HMGrunthos/InrushTimer/PCBProcessingTimes.jpg

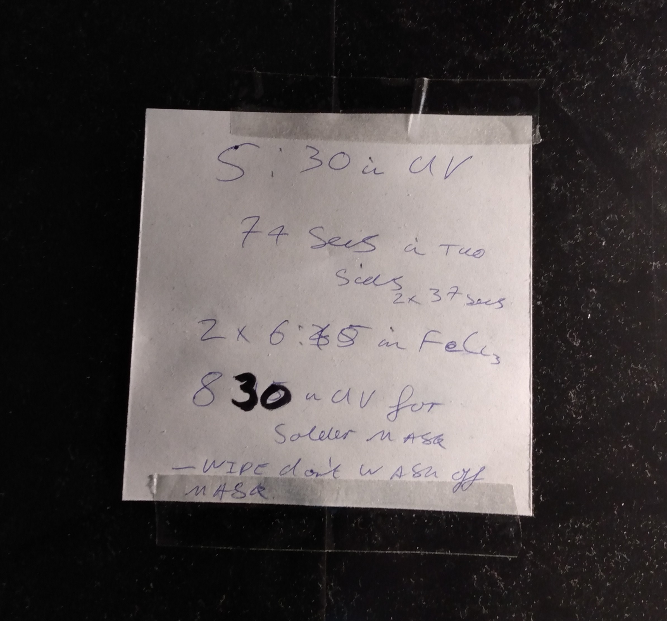
PCBProcessingTimes.jpg
