HMGrunthos/InrushTimer/InrushTimerArkwork.pdf

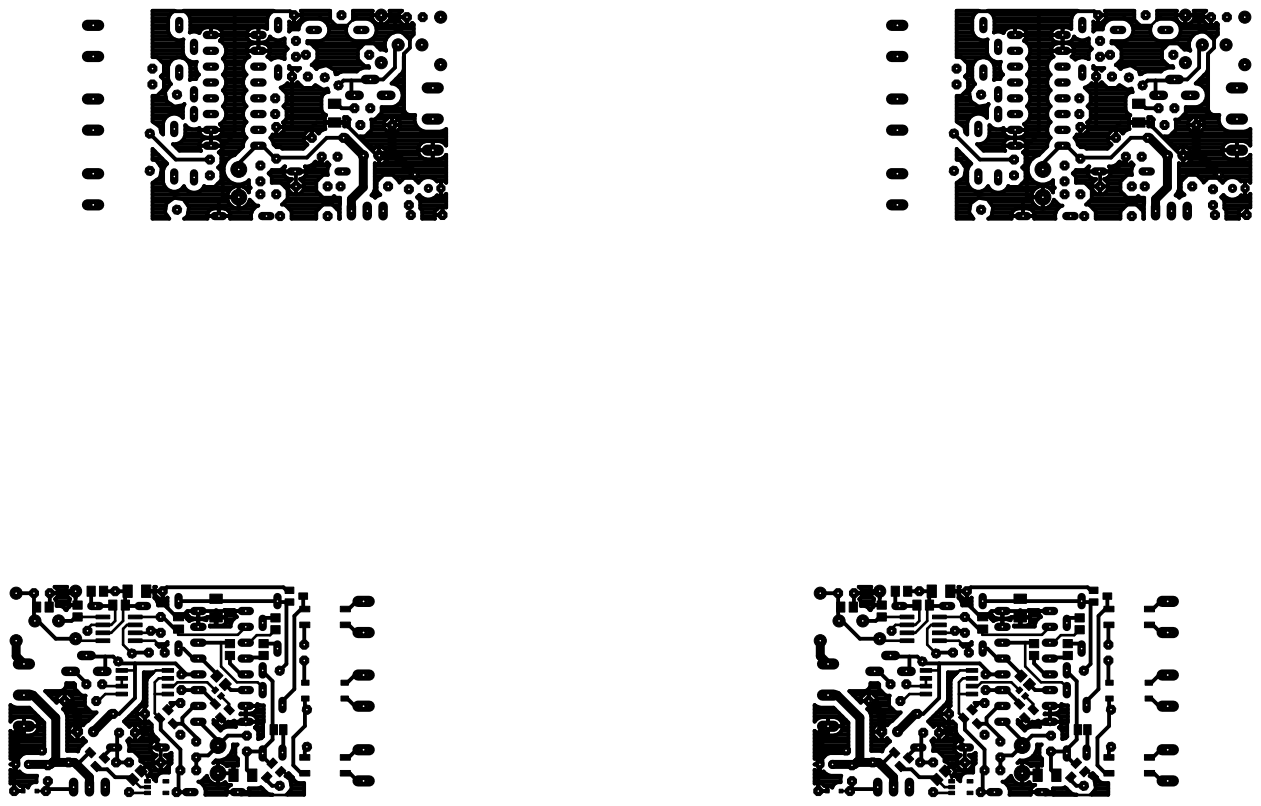
[picture p2: page 1]
