HMGrunthos/InrushTimer/InrushTimerStopMask.pdf

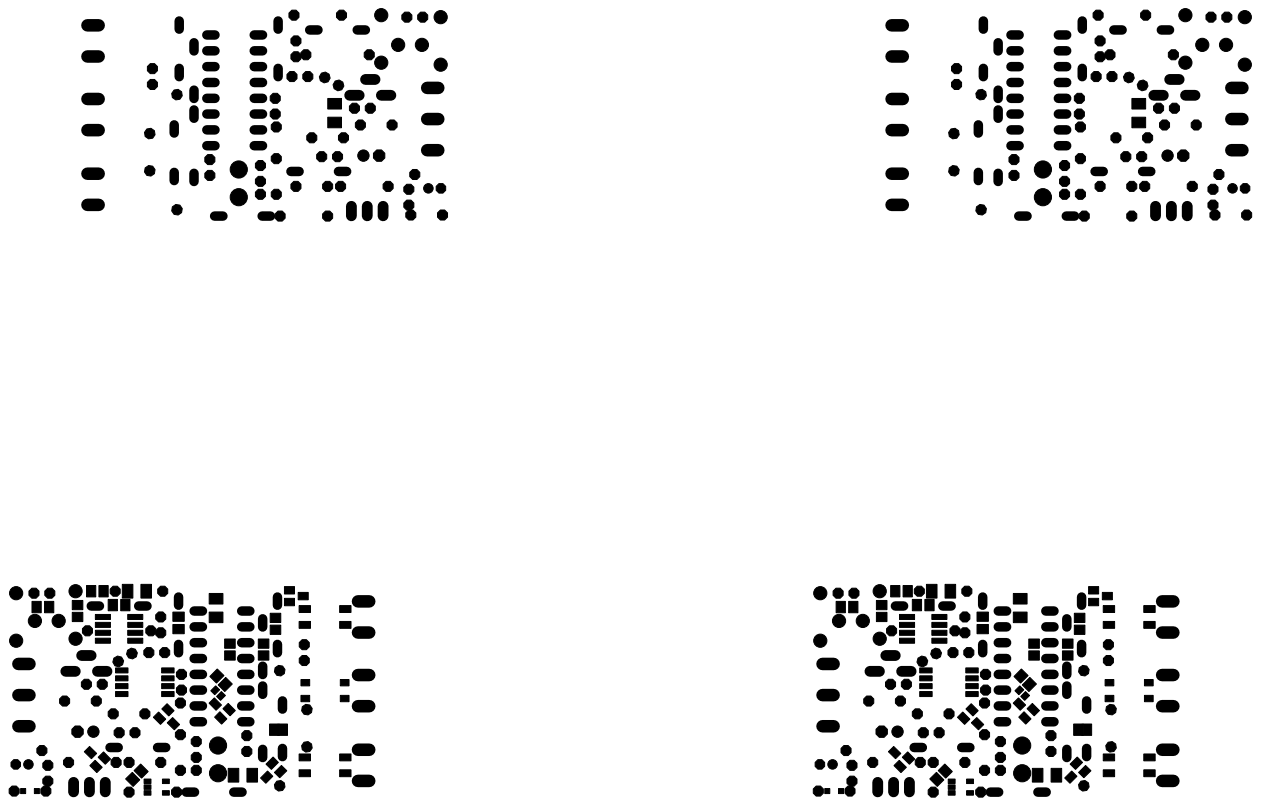
[picture p3: page 1]
