HMGrunthos/InrushTimer/InrushTimer-6.asc

A1: dflop; Trise=5n Tfall=5n Td=5n Vhigh=11.2
A2: dflop; Trise=5n Tfall=5n Td=5n Vhigh=11.2
A3: dflop; Trise=5n Tfall=5n Td=5n Vhigh=11.2
A4: dflop; Trise=5n Tfall=5n Td=5n Vhigh=11.2
C1: cap; 10e-6
C2: cap; 100e-9
C3: cap; 330e-9
C4: cap; 2e-9
C5: cap; 10e-6
C6: cap; 10e-9
C7: cap; 0.01e-6; V=16
C8: cap; 100e-6
C9: cap; 100e-9
C10: cap; 5e-12
C11: cap; 2.2e-6
C13: cap; 100e-9
C15: cap; 130e-12
C16: cap; 130e-12
C17: cap; 100e-9
C18: cap; 10e-9
C19: cap; 130e-12
D1: diode; RR2L6S
D2: diode; RR2L6S
D3: diode; RR2L6S
D4: diode; RR2L6S
D5: zener; mm3z12vt1g
D6: diode; 5082-2800
D7: diode; 1N4001
D8: diode; STTH110
D9: diode; 1N4001
D10: diode; 1N4148
D11: zener; NZX5V6C
D12: diode; 1N4148
D13: diode; 1N4148
D15: diode; 1N4148
D16: diode; 1N4148
D17: zener; NZX5V6C
L1: ind; 0.2; Rser=0.2
M2: nmos; F2N7002
M3: nmos; F2N7002
M4: nmos; F2N7002
M5: nmos; F2N7002
Q1: npn; MMBTA05
Q3: npn; ZTX450
R1: res; 100e3
R2: res; 10e3
R3: res; 22e3
R4: res; 1e6
R5: res; 4.7e3
R6: res; 51e3
R7: res; 9.1e6
R8: res; 1e3
R9: res; 22e3
R10: res; 100e3
R11: res; 100
R12: res; 200e3
R13: res; 51e3
R14: res; 1e6
R15: res; 1.5e3
R16: res; 10e3
R17: res; 200e3
R18: res; 1e3
R19: res; 10e3
R20: res; 4e3
R21: res; 4e3
R22: res; 10e3
R23: res; 200e3
R24: res; 100
R25: res; 36
R26: res; 10e3
R27: res; 4e3
R28: res; 200e3
R29: res; 27e3
R32: res; 10e3
R36: res; 10e3
U1: opamp2; TLC272
U2: opamp2; TLC272
U3: NE555
U4: bu4830
U5: LED_TRIAC_ZCS; MOC3083
U6: LED_TRIAC_ZCS; MOC3083
U7: LED_TRIAC_ZCS; MOC3083
V1: voltage; 0
V2: voltage; SINE(0 340 50 0 0 0 40); AC 1
V3: voltage; 0
W1: csw; V1 OptoSwitch
W2: csw; V3 OptoSwitch
Named nets: L, N, 12V, 0, Rect, Zero, HalfIn, Sig, Peak, PeakValue, Reset, nReset, TCharge, CV, Out, pd
.MODEL ZTX450 NPN IS =3.941445E-14 BF =175 VAF=109.45 NF =1 IKF=.8 ISE=7.4025E-15 NE =1.3 BR =20.5 VAR=14.25 NR =.974 IKR=.1 ISC=3.157E-13 NC =1.2 RB =1.1 RE =.1259 RC =.0539 CJE=63E-12 TF =.75E-9 CJC=15.8E-12 TR =85E-9 VJC=.505 MJC=.39
.lib MM3Z12VT1G.LIB
.include MOC308x.lib
.include thyristr.lib
.lib TLC272.101
.MODEL 5082-2800  D(IS=2.2E-9, CJO=1.6E-12, VJ=.6, BV=75, IBV=1E-5 EG=0.69, N=1.08, RS=25, XTI=2, M=0.5)
.lib 2N7002.lib
.tran 1
.MODEL MMBTA05  NPN (IS=51.3f NF=1.00 BF=547 VAF=139 IKF=0.146 ISE=11.1p NE=2.00 BR=4.00 NR=1.00 VAR=16.0 IKR=0.360 RE=0.223 RB=0.892 RC=89.2m XTB=1.5 CJE=58.7p VJE=1.10 MJE=0.500 CJC=18.9p VJC=0.300 MJC=0.300 TF=631p TR=110n EG=1.12 )
.ic V(TCharge)=0
.MODEL STTH110 D IS=503.98E-9 N=2.7057 RS=52.911E-3 IKF=.11996 CJO=45.822E-12 M=5.0985 VJ=9.9900 ISR=10.010E-21 NR=4.9950 FC=0.5 TT=70.000E-9
.model 1N4001 D(Is=14.11n N=1.984 Rs=33.89m Ikf=94.81 Xti=3 Eg=1.11 Cjo=25.89p M=.44 Vj=.3245 Fc=.5 Bv=75 Ibv=10u Tt=5.7u Iave=1 Vpk=50 mfg=GI type=silicon)
.MODEL TIP41C NPN (IS=7.55826e-11 BF=260.542 NF=1.11221 VAF=100 IKF=0.526814 ISE=1e-08 NE=2.18072 BR=26.0542 NR=1.5 VAR=1000 IKR=3.54059 ISC=1e-08 NC=1.63849 RB=4.56157 IRB=0.1 RBM=0.1 RE=0.0162111 RC=0.0810556 XTB=0.1 XTI=1 EG=1.206 CJE=1.93296e-10 VJE=0.4 MJE=0.259503 TF=1e-08 XTF=4.06972 VTF=7.1157 ITF=0.001 CJC=1.09657e-10 VJC=0.730921 MJC=0.23 XCJC=0.803085 FC=0.8 TR=9.01013e-08 PTF=0 Vceo=100 ICrating=6 mfg=ON_Semi)
.step param Cfc list 1e-9 3.3e-9
.model OptoSwitch CSW(Roff=1Meg Ron=1e-3 It=1mA Ih=10uA)
.inc NZX5V6C.prm
.meas TRAN PulseRise TRIG V(Peak)=1 TD=3u RISE=6 TARG V(Peak)=9 TD=3u RISE=3
At least one CLK pin capacitance
Can also be TIP41C
.meas TRAN PulseFall TRIG V(Peak)=9 TD=3u FALL=3 TARG V(Peak)=1 TD=3u FALL=6
.options cshunt=1e-15
Prefer ZTX451 for worst case CE violations
.MODEL RR2L6S D IS=1.5392E-9 N=1.6310 RS=16.849E-3 IKF=17.962 EG=.97 CJO=44.000E-12 M=.40234 VJ=.51261 ISR=1.4208E-9 NR=3.3000 BV=600 TT=5.9300E-6 TRS1=0.001
