HMGrunthos/InrushTimer/InrushProtection.asc

NTC1: xvaristor; S237_33
NTC2: xvaristor; S237_33
NTC3: xvaristor; S237_60
NTC4: xvaristor; S237_60
NTC5: xvaristor; S237_60
NTC6: xvaristor; S237_60
NTC7: xvaristor; S237_60
NTC8: xvaristor; S237_60
NTC9: xvaristor; S237_60
NTC10: xvaristor; S237_60
NTC11: xvaristor; S237_60
NTC12: xvaristor; S237_60
NTC13: xvaristor; S237_33
NTC14: xvaristor; S237_33
NTC15: xvaristor; S237_33
NTC16: xvaristor; S237_33
NTC17: xvaristor; S237_33
NTC18: xvaristor; S237_33
NTC19: xvaristor; S237_33
NTC20: xvaristor; S237_33
NTC21: xvaristor; S237_33
NTC22: xvaristor; S237_33
NTC23: xvaristor; S237_33
NTC24: xvaristor; S237_33
NTC26: xvaristor; S237_33
R1: res; 2.9
R2: res; 2.9
R3: res; 52.17
R4: res; 0
R5: res; 2.9
R6: res; 68; pwr=30
R7: res; 68; pwr=30
R8: res; 68; pwr=30
R9: res; 68; pwr=30
R10: res; 68; pwr=30
R11: res; 68; pwr=30
V1: voltage; SINE(0 340 50 0 0 0)
V2: voltage; SINE(0 340 50 0 0 0)
V3: voltage; SINE(0 340 50 0 0 0)
V4: voltage; SINE(0 340 50 0 0 0)
Named nets: 0
.tran 1
.lib ntc_20130313.lib
