HMGrunthos/InrushTimer/RelayTimer-1.asc

C1: cap; 200e-6
C2: cap; 220e-9
D1: diode; RR2L6S
D2: diode; RR2L6S
D3: diode; RR2L6S
D4: diode; RR2L6S
D5: diode; 1N4001
D6: zener; BZX84C15L
L1: ind; 200e-3; Rser=960
R1: res; 470
R2: res; 7.5e3
R5: res; 1e6
R6: res; 100
U1: SCR; EC103D1
V2: voltage; SINE(0 340 50 0 0 0 50); AC 1
Named nets: L, N, 0
.lib Thyristor_SCR_EC103xx_SxSx_A_SPICE_Model_lib.lib
.tran 2
.model 1N4001 D(Is=14.11n N=1.984 Rs=33.89m Ikf=94.81 Xti=3 Eg=1.11 Cjo=25.89p M=.44 Vj=.3245 Fc=.5 Bv=75 Ibv=10u Tt=5.7u Iave=1 Vpk=50 mfg=GI type=silicon)
