HMGrunthos/InrushTimer/InrushTimer-4.asc

A1: dflop; Trise=5n Tfall=5n Td=5n Vhigh=11.2
A2: dflop; Trise=5n Tfall=5n Td=5n Vhigh=11.2
A3: dflop; Trise=5n Tfall=5n Td=5n Vhigh=11.2
C1: cap; 10e-6
C2: cap; 100e-9
C3: cap; 220e-9
C4: cap; 1e-9
C5: cap; 10e-6
C6: cap; 10e-6
C7: cap; 0.01e-6; V=16
C8: cap; 10e-6
C9: cap; 100e-9
C10: cap; 0.01e-6; V=16
C11: cap; 1e-6
C12: cap; 10e-9
C13: cap; 100e-9
C15: cap; 10e-9
C16: cap; 130e-12
D1: diode; RR2L6S
D2: diode; RR2L6S
D3: diode; RR2L6S
D4: diode; RR2L6S
D5: zener; mm3z12vt1g
D6: diode; 5082-2800
D7: diode; 1N5819HW
D8: diode; UF5406
D9: diode; 1N5819HW
D10: diode; 1N4148
D11: zener; BZX84C15L
D12: diode; 1N4148
D13: zener; DZ2J036
L2: ind; 54.2; Rser=4e3
M1: nmos; F2N7002
M2: nmos; F2N7002
M3: nmos; F2N7002
M4: nmos; F2N7002
Q1: npn; ZTX450
R1: res; 10e3
R2: res; 200e3
R3: res; 2.2e3
R4: res; 1e6
R5: res; 4.7e3
R6: res; 51e3
R7: res; 10e6
R8: res; 51e3
R9: res; 22e3
R10: res; 200e3
R11: res; 100
R12: res; 47e3
R13: res; 51e3
R14: res; 100e3
R16: res; 37.5e3
R17: res; 37.5e3
R18: res; 1.55e3
R19: res; 25e3
R23: res; 51e3
R27: res; 47
R28: res; 330
R29: res; 2527
S1: sw; MainsOff
S2: sw; OptoOn
S3: sw; OptoOnInvert
U1: opamp2; TLC272
U2: opamp2; TLC272
U3: NE555
U4: bu4831
U5: LED_TRIAC_ZCS; MOC3083
U7: TRIAC; MAC97A6
V1: voltage; PWL(0 -1 0.324 -1 0.325 1 0.349 1 0.350 -1 0.599 -1 .600 1 .649 1 .650 -1)
V2: voltage; SINE(0 340 50); AC 1
Named nets: L, N, 12V, 0, Rect, Zero, HalfIn, Sig, Peak, Hyst, PeakValue, Reset, nReset, TCharge, CV, Out
.MODEL ZTX450 NPN IS =3.941445E-14 BF =175 VAF=109.45 NF =1 IKF=.8 ISE=7.4025E-15 NE =1.3 BR =20.5 VAR=14.25 NR =.974 IKR=.1 ISC=3.157E-13 NC =1.2 RB =1.1 RE =.1259 RC =.0539 CJE=63E-12 TF =.75E-9 CJC=15.8E-12 TR =85E-9 VJC=.505 MJC=.39
.lib MM3Z12VT1G.LIB
.include MOC308x.lib
.include thyristr.lib
.lib TLC272.101
.MODEL 5082-2800  D(IS=2.2E-9, CJO=1.6E-12, VJ=.6, BV=75, IBV=1E-5 EG=0.69, N=1.08, RS=25, XTI=2, M=0.5)
.lib 2N7002.lib
.model uf5406 d(is = 1.15563E-005 n = 3.45 rs = 0.0887337 eg = 1.11 xti = 3 cjo = 9.14327E-011 vj = 0.298558 m = 0.347605 fc = 0.5  tt = 1.57227E-007 bv = 660 ibv = 0.3 af = 1 kf = 0)
.MODEL MainsOff SW(Vt=0.0)
.lib PDTC123EM.prm
.MODEL 1N5819HW D ( IS=191u RS=42.0m BV=40.0 IBV=1.00m CJO=239p  M=0.333 N=1.70 TT=7.20n )
.tran 1.5
.MODEL MMBTA05  NPN (IS=51.3f NF=1.00 BF=547 VAF=139 IKF=0.146 ISE=11.1p NE=2.00 BR=4.00 NR=1.00 VAR=16.0 IKR=0.360 RE=0.223 RB=0.892 RC=89.2m XTB=1.5 CJE=58.7p VJE=1.10 MJE=0.500 CJC=18.9p VJC=0.300 MJC=0.300 TF=631p TR=110n EG=1.12 )
.ic V(TCharge)=0
.MODEL OptoOn SW(Vt=5)
.MODEL OptoOnInvert SW(Vt=5 Ron=1e12 Roff=1e-12)
.lib dz2j036.lib
