HMGrunthos/InrushTimer/InrushTimer-2.asc

A1: dflop
C1: cap; 10e-6
C2: cap; 100e-9
C3: cap; 220e-9
C4: cap; 1e-9
C5: cap; 10e-6
C6: cap; 10e-6
C7: cap; 0.01e-6; V=16
C8: cap; 10e-6
C9: cap; 1e-9
C10: cap; 1e-6; V=16
C11: cap; 100e-9
C12: cap; 10e-9
D1: diode; RR2L6S
D2: diode; RR2L6S
D3: diode; RR2L6S
D4: diode; RR2L6S
D5: zener; mm3z12vt1g
D6: diode; 5082-2800
D7: diode; 1N4148
D8: diode; RR2L6S
D9: diode; RR2L6S
L1: ind; 47; Rser=4e3
M1: nmos; F2N7002
Q1: npn; ZTX450
R1: res; 51e3
R2: res; 100e3
R3: res; 2.2e3
R4: res; 1e6
R5: res; 2.2e3
R6: res; 220e3
R7: res; 10e6
R8: res; 10e3
R9: res; 10e3
R10: res; 0
R11: res; 100
R12: res; 100e3
R14: res; 100e3
R16: res; 390
R17: res; 47
U1: opamp2; TLC272
U2: opamp2; TLC272
U3: NE555
U4: TRIAC; MAC97A6
V2: voltage; SINE(0 340 50)
Named nets: L, N, 12V, 0, Rect, Zero, VbrL, VbrN, Din, Sig, Ref, Adj, Peak
.MODEL ZTX450 NPN IS =3.941445E-14 BF =175 VAF=109.45 NF =1 IKF=.8 ISE=7.4025E-15 NE =1.3 BR =20.5 VAR=14.25 NR =.974 IKR=.1 ISC=3.157E-13 NC =1.2 RB =1.1 RE =.1259 RC =.0539 CJE=63E-12 TF =.75E-9 CJC=15.8E-12 TR =85E-9 VJC=.505 MJC=.39
.lib MM3Z12VT1G.LIB
.tran .5
.include MOC308x.lib
.include thyristr.lib
.lib TLC272.101
.MODEL 5082-2800  D(IS=2.2E-9, CJO=1.6E-12, VJ=.6, BV=75, IBV=1E-5 EG=0.69, N=1.08, RS=25, XTI=2, M=0.5)
.lib 2N7002.lib
