HMGrunthos/InrushTimer/InrushTimer-1.asc

C1: cap; 100e-9
C2: cap; 10e-6
C3: cap; 220e-9
C4: cap; 10e-9
C5: cap; 10e-6
C6: cap; 10e-6
C7: cap; 0.01e-6; V=16
C8: cap; 10e-6
C9: cap; 5e-6; V=16
D1: diode; RR2L6S
D2: diode; RR2L6S
D3: diode; RR2L6S
D4: diode; RR2L6S
D5: zener; mm3z12vt1g
D8: diode; 1N4148
L1: ind; 47; Rser=4e3
Q1: npn; ZTX450
R1: res; 220e3
R4: res; 1e6
R5: res; 2.2e3
R6: res; 1.8e3
R7: res; 390
R8: res; 390
R9: res; 47
R10: res; 100
U1: TRIAC; MAC97A6
U2: NE555
U3: LED_TRIAC_ZCS; moc3083
V2: voltage; SINE(0 340 50)
Named nets: L, N, 12V, 0, VTimer, Vrect, Vzero, VRef, VbrL, VbrN, Vtimer
.MODEL ZTX450 NPN IS =3.941445E-14 BF =175 VAF=109.45 NF =1 IKF=.8 ISE=7.4025E-15 NE =1.3 BR =20.5 VAR=14.25 NR =.974 IKR=.1 ISC=3.157E-13 NC =1.2 RB =1.1 RE =.1259 RC =.0539 CJE=63E-12 TF =.75E-9 CJC=15.8E-12 TR =85E-9 VJC=.505 MJC=.39
.lib MM3Z12VT1G.LIB
.tran 2
.include MOC308x.lib
.include thyristr.lib
