HMGrunthos/InrushTimer/SwitchingBoardKiCad/SwitchingBoard.kicad_pcb

## KiCad design SwitchingBoardKiCad/SwitchingBoard.kicad_pcb (2022-06-03)

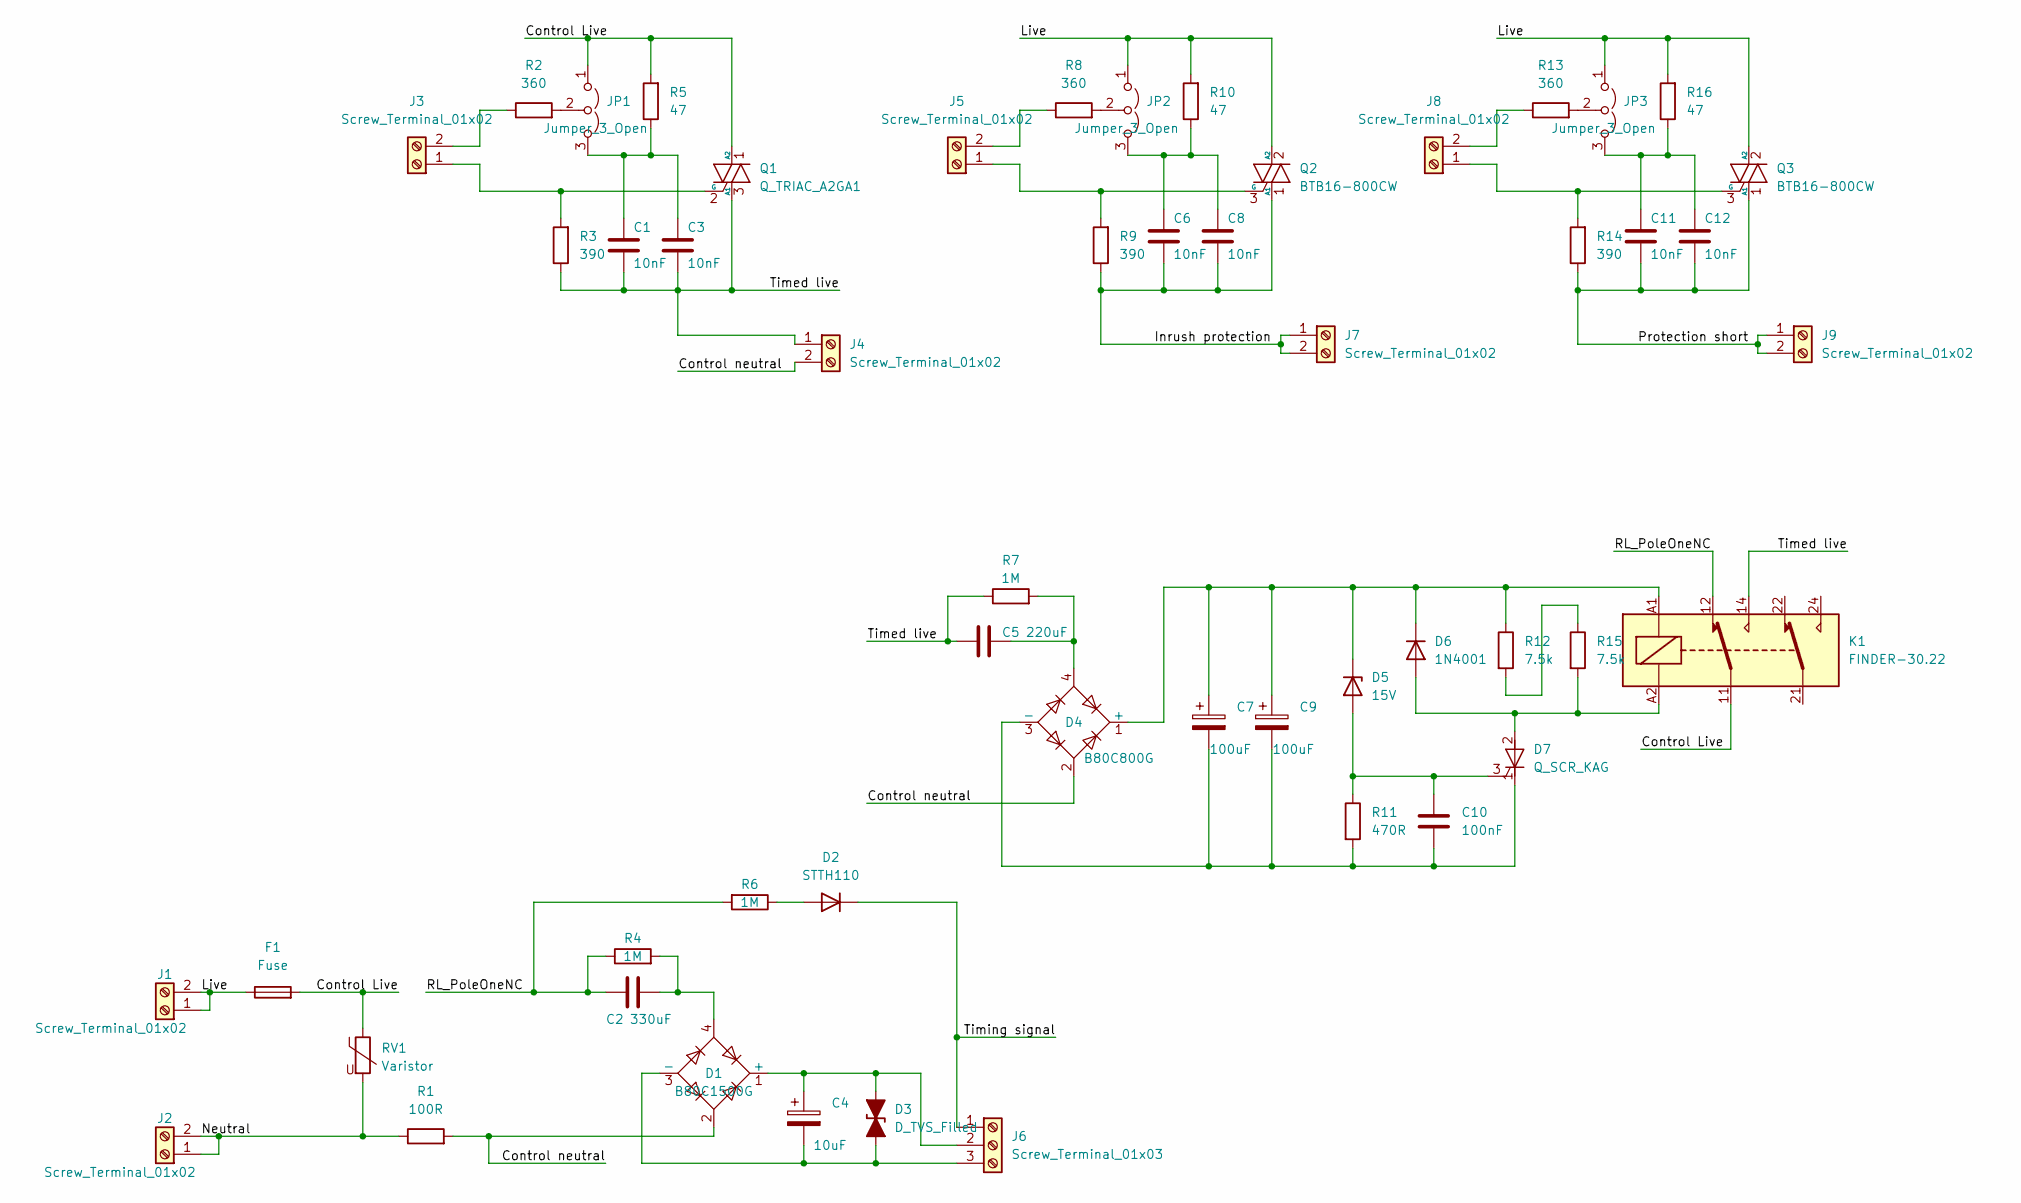
[picture p4: schematic SwitchingBoard.kicad_sch]

Parts:
C1, C3, C6, C8, C11, C12: 10nF; C_Rect_L18.0mm_W5.0mm_P15.00mm_FKS3_FKP3
C2: 330uF; C_Rect_L18.0mm_W9.0mm_P15.00mm_FKS3_FKP3
C4: 10uF; CP_Radial_D5.0mm_P2.00mm
C5: 220uF; C_Rect_L26.5mm_W6.0mm_P22.50mm_MKS4
C7, C9: 100uF; CP_Radial_D6.3mm_P2.50mm
C10: 100nF; C_Disc_D5.0mm_W2.5mm_P5.00mm
D1: B80C1500G; Diode_Bridge_Round_D9.8mm
D2: STTH110; D_DO-41_SOD81_P10.16mm_Horizontal
D3: D_TVS_Filled; D_DO-15_P12.70mm_Horizontal
D4: B80C800G; Diode_Bridge_Round_D9.8mm
D5: 15V; D_DO-35_SOD27_P7.62mm_Horizontal
D6: 1N4001; D_DO-41_SOD81_P10.16mm_Horizontal
D7: Q_SCR_KAG; TO-220-3_Horizontal_TabDown
F1: Fuse; Fuseholder_Clip-5x20mmOr6.3x32_Schurter_OG_Lateral_P20.00x5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
J1, J2, J3, J4, J5, J7, J8, J9: Screw_Terminal_01x02; TerminalBlock_Altech_AK300-2_P5.00mm
J6: Screw_Terminal_01x03; TerminalBlock_Altech_AK300-3_P5.00mm
JP1, JP2, JP3: Jumper_3_Open; TerminalBlock_4Ucon_1x03_P3.50mm_Horizontal
K1: FINDER-30.22; Relay_DPDT_Finder_40.52
Q1: Q_TRIAC_A2GA1; TO-92L_Inline
Q2, Q3: BTB16-800CW; TO-220-3_Vertical
R1: 100R; R_Axial_Power_L20.0mm_W6.4mm_P22.40mm
R2, R8, R13: 360; R_Axial_DIN0207_L6.3mm_D2.5mm_P10.16mm_Horizontal
R3, R9, R14: 390; R_Axial_DIN0207_L6.3mm_D2.5mm_P10.16mm_Horizontal
R4, R6, R7: 1M; R_Axial_Power_L20.0mm_W6.4mm_P22.40mm
R5, R10, R16: 47; R_Axial_DIN0207_L6.3mm_D2.5mm_P10.16mm_Horizontal
R11: 470R; R_Axial_DIN0207_L6.3mm_D2.5mm_P10.16mm_Horizontal
R12, R15: 7.5k; R_Axial_DIN0207_L6.3mm_D2.5mm_P10.16mm_Horizontal
RV1: Varistor; RV_Disc_D12mm_W4.3mm_P7.5mm

Connections:
/Control Live: F1.2, JP1.1 (A), K1.11, Q1.1 (A2), R5.2, RV1.1
/Control neutral: D1.2, D4.2, J4.2, R1.2
/Inrush protection: C6.1, C8.1, J7.1, J7.2, Q2.1 (A1), R9.1
/Live: F1.1, J1.1, J1.2, JP2.1 (A), JP3.1 (A), Q2.2 (A2), Q3.2 (A2), R10.2, R16.2
/Neutral: J2.1, J2.2, R1.1, RV1.2
/Protection short: C11.1, C12.1, J9.1, J9.2, Q3.1 (A1), R14.1
/RL_PoleOneNC: C2.1, K1.12, R4.1, R6.2
/Timed live: C1.1, C3.1, C5.1, J4.1, K1.14, Q1.3 (A1), R3.1, R7.1
/Timing signal: D2.1 (K), J6.1
unnamed: C1.2, C3.2, JP1.3 (B), R5.1
unnamed: C2.2, D1.4, R4.2
unnamed: C4.1, D1.1 (+), D3.2 (A2), J6.2
unnamed: C4.2, D1.3 (-), D3.1 (A1), J6.3
unnamed: C5.2, D4.4, R7.2
unnamed: C6.2, C8.2, JP2.3 (B), R10.1
unnamed: C7.1, C9.1, D4.1 (+), D5.1 (K), D6.1 (K), K1.A1, R12.1
unnamed: C7.2, C9.2, C10.1, D4.3 (-), D7.1 (K), R11.2
unnamed: C10.2, D5.2 (A), D7.3 (G), R11.1
unnamed: C11.2, C12.2, JP3.3 (B), R16.1
unnamed: D2.2 (A), R6.1
unnamed: D6.2 (A), D7.2 (A), K1.A2, R15.2
unnamed: J3.1, Q1.2 (G), R3.2
unnamed: J3.2, R2.1
unnamed: J5.1, Q2.3 (G), R9.2
unnamed: J5.2, R8.1
unnamed: J8.1, Q3.3 (G), R14.2
unnamed: J8.2, R13.1
unnamed: JP1.2 (C), R2.2
unnamed: JP2.2 (C), R8.2
unnamed: JP3.2 (C), R13.2
unnamed: R12.2, R15.1

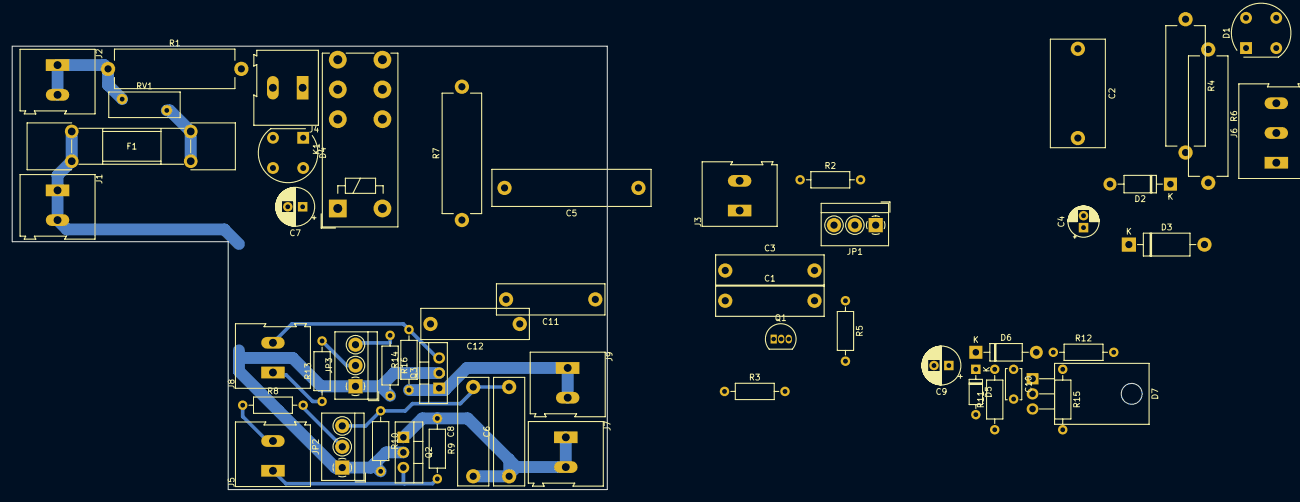
[picture p5: board SwitchingBoard.kicad_pcb from above]

Board: 2 copper layers, 100.0 x 74.5 mm, 53 parts (0 on the bottom side), 31 nets.
