HMGrunthos/InrushTimer/InrushTimer.brd

## EAGLE design InrushTimer.brd (2022-10-17)

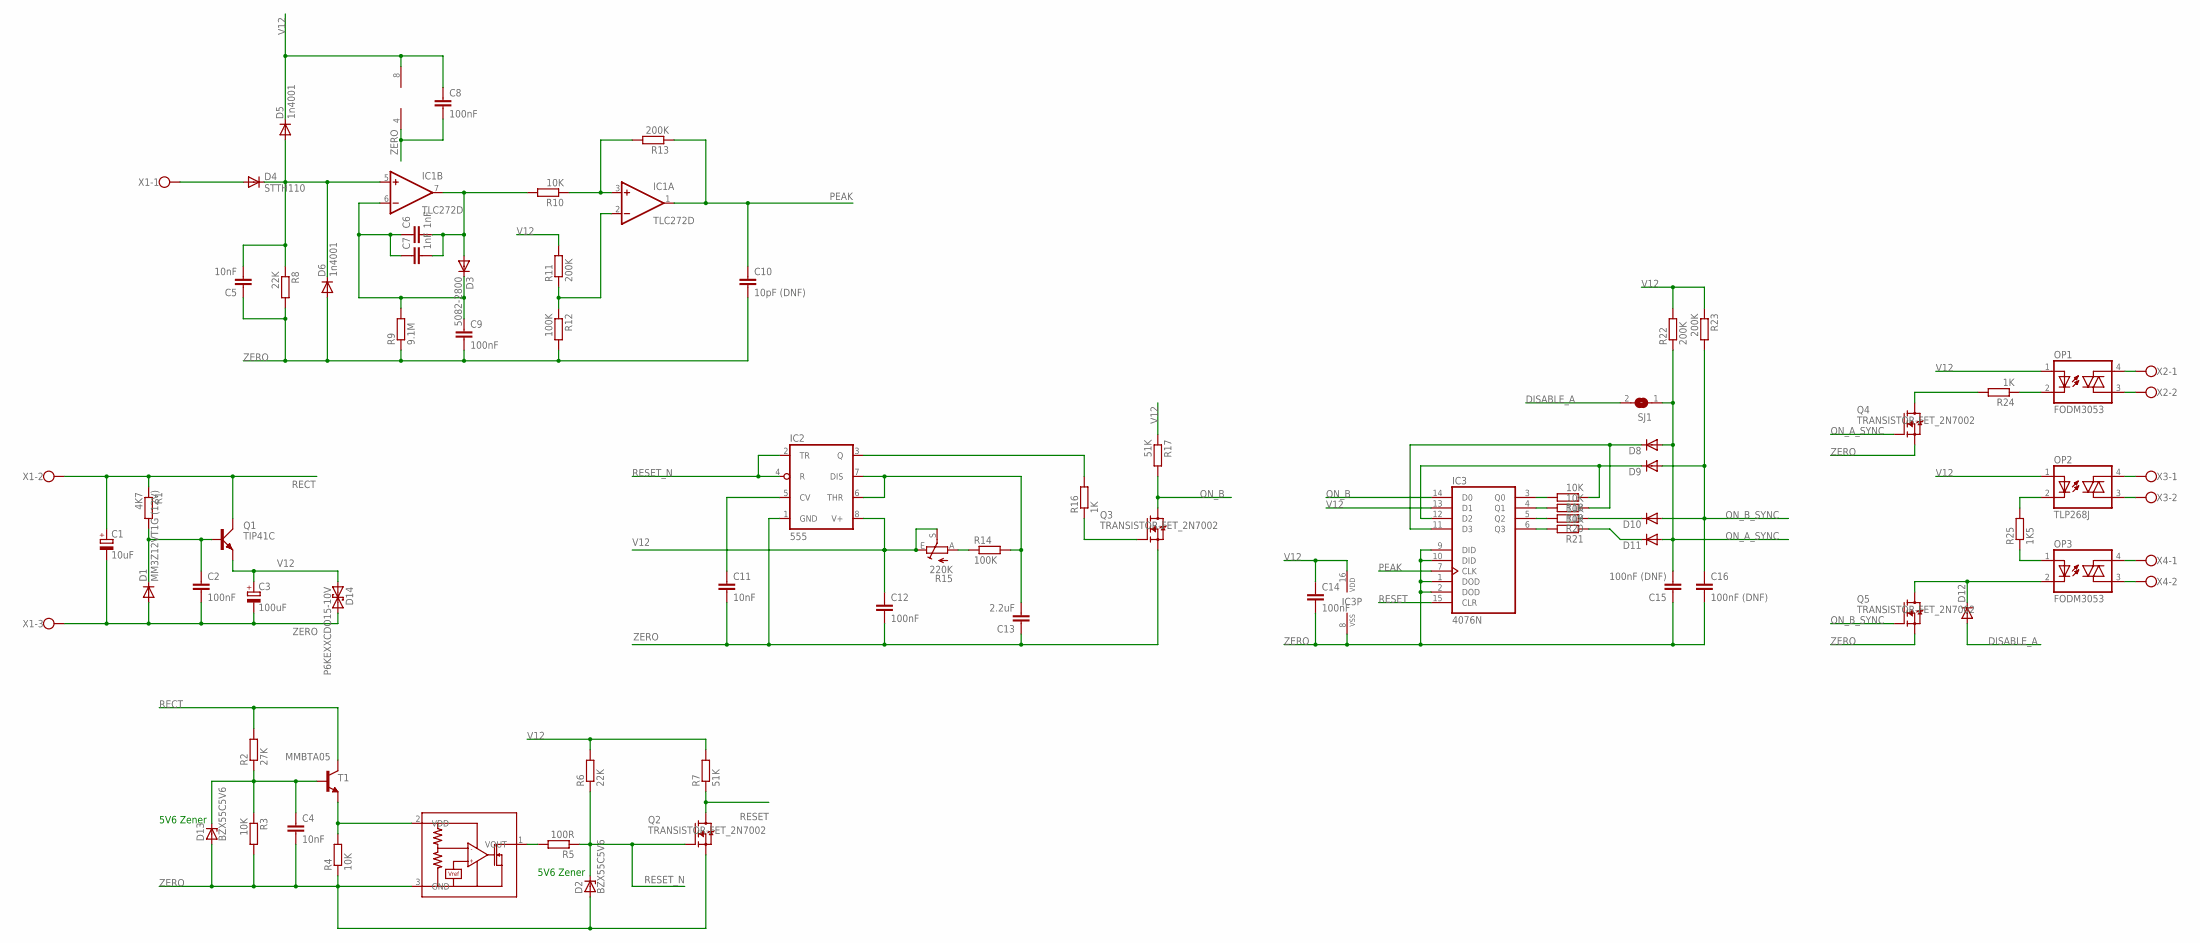
[picture p6: schematic InrushTimer.sch]

Parts:
C1: 10uF; E2-5
C2, C12, C14: 100nF; C050-024X044
C3: 100uF; E2,5-7
C4, C11: 10nF; C050-024X044
C5: 10nF; C0805K
C6, C7: 1nF; C0805K
C8: 100nF; C0805
C9: 100nF; C1206K
C10: 10pF (DNF); C0805K
C13: 2.2uF; C1206K
C15, C16: 100nF (DNF); C1206K
D1: MM3Z12VT1G (12V); SOD323-R
D2, D13: BZX55C5V6; DO34Z7
D3: 5082-2800; DO34-7
D4: STTH110; DO41-7.6
D5: 1n4001; DO41-10VN
D6: 1n4001; DO41-7.6
D8: 1N4148DO35-10; DO35-10
D9, D10, D11, D12: 1N4148DO35-7; DO35-7
D14: P6KEXXCDO15-10V; DO15-10V
IC1: TLC272D; SO08
IC2: 555; SO08-555
IC3: 4076N; DIL16
OP1, OP3: FODM3053; FODM
OP2: TLP268J; TLP26*
Q1: TIP41C; TO220AV
Q2, Q3, Q4, Q5: TRANSISTOR-FET_2N7002; TRANSISTOR-FET_SOT23
R1: 4K7; 0207/2V
R2: 27K; 0207/7
R3: 10K; 0207/2V
R4, R18, R19, R20, R21: 10K; R0805
R5: 100R; 0207/7
R6, R8: 22K; 0207/2V
R7, R17: 51K; 0207/2V
R9: 9.1M; 0207/7
R10: 10K; 0207/10
R11, R13, R22: 200K; 0207/2V
R12, R14: 100K; 0207/2V
R15: 220K; CA6H
R16: 1K; R0402
R23: 200K; 0207/7
R24: 1K; 0207/7
R25: 1K5; 0207/2V
SJ1: SJ
T1: MMBTA05; SOT23-BEC
U1: ROHM_BY_ELEMENT14_BATCH_1_BU48XXG; ROHM_BY_ELEMENT14_BATCH_1_SOT95P280X125-5N
X1: W237-103
X2, X3, X4: W237-102

Connections:
DISABLE_A: D12.A, SJ1.2
unnamed: D4.A, X1.1
unnamed: R14.1, R15.A
unnamed: IC3.6 (Q3), R21.2
unnamed: OP3.4 (A2), X4.1
unnamed: OP1.3 (A1), X2.2
unnamed: D12.C, OP3.2 (C), Q5.3 (D)
unnamed: C6.2, C7.2, D3.A, IC1.7 (OUT), R10.2
unnamed: C2.1, D1.C, Q1.B, R1.2
unnamed: C6.1, C7.1, C9.1, D3.C, IC1.6 (-IN), R9.2
unnamed: OP1.4 (A2), X2.1
unnamed: C5.2, D4.C, D5.A, D6.C, IC1.5 (+IN), R8.1
unnamed: OP3.3 (A1), X4.2
unnamed: R4.2, T1.E, U1.2 (VDD)
unnamed: C4.1, D13.C, R2.1, R3.1, T1.B
unnamed: OP3.1 (A), R25.1
unnamed: D9.C, IC3.12 (D2), R18.1
unnamed: OP2.2 (C), R25.2
unnamed: OP1.2 (C), R24.1
unnamed: IC3.5 (Q2), R20.2
unnamed: OP2.4 (A2), X3.1
unnamed: OP2.3 (A1), X3.2
unnamed: D8.C, IC3.11 (D3), R19.1
unnamed: R5.2, U1.1 (VOUT)
unnamed: D11.C, R21.1
unnamed: IC3.4 (Q1), R19.2
unnamed: IC1.3 (+IN), R10.1, R13.2
unnamed: C13.2, IC2.6 (THR), IC2.7 (DIS), R14.2
unnamed: D10.C, R20.1
unnamed: Q4.3 (D), R24.2
unnamed: IC3.3 (Q0), R18.2
unnamed: Q3.1 (G), R16.1
unnamed: C11.1, IC2.5 (CV)
unnamed: IC2.3 (Q), R16.2
ON_A_SYNC: C15.2, D8.A, D11.A, Q4.1 (G), R22.1, SJ1.1
ON_B: IC3.14 (D0), Q3.3 (D), R17.2
ON_B_SYNC: C16.1, D9.A, D10.A, Q5.1 (G), R23.2
PEAK: C10.1, IC1.1 (OUT), IC3.7 (CLK), R13.1
RECT: C1.+, Q1.C, R1.1, R2.2, T1.C, X1.2
RESET: IC3.15 (CLR), Q2.3 (D), R7.1
RESET_N: D2.C, IC2.2 (TR), IC2.4 (R), Q2.1 (G), R5.1, R6.1
THRESH: IC1.2 (-IN), R11.1, R12.1
V12: C3.+, C8.1, C12.1, C14.1, D5.C, D14.A (1), IC1.8 (V+), IC2.8 (V+), IC3.13 (D1), IC3.16 (VDD), OP1.1 (A), OP2.1 (A), Q1.E, R6.2, R7.2, R11.2, R15.E, R15.S, R17.1, R22.2, R23.1
ZERO: C1.-, C2.2, C3.-, C4.2, C5.1, C8.2, C9.2, C10.2, C11.2, C12.2, C13.1, C14.2, C15.1, C16.2, D1.A, D2.A, D6.A, D13.A, D14.C (2), IC1.4 (V-), IC2.1 (GND), IC3.1 (DOD), IC3.2 (DOD), IC3.8 (VSS), IC3.9 (DID), IC3.10 (DID), Q2.2 (S), Q3.2 (S), Q4.2 (S), Q5.2 (S), R3.2, R4.1, R8.2, R9.1, R12.2, U1.3 (GND), X1.3

Notes on the sheet:
5V6 Zener

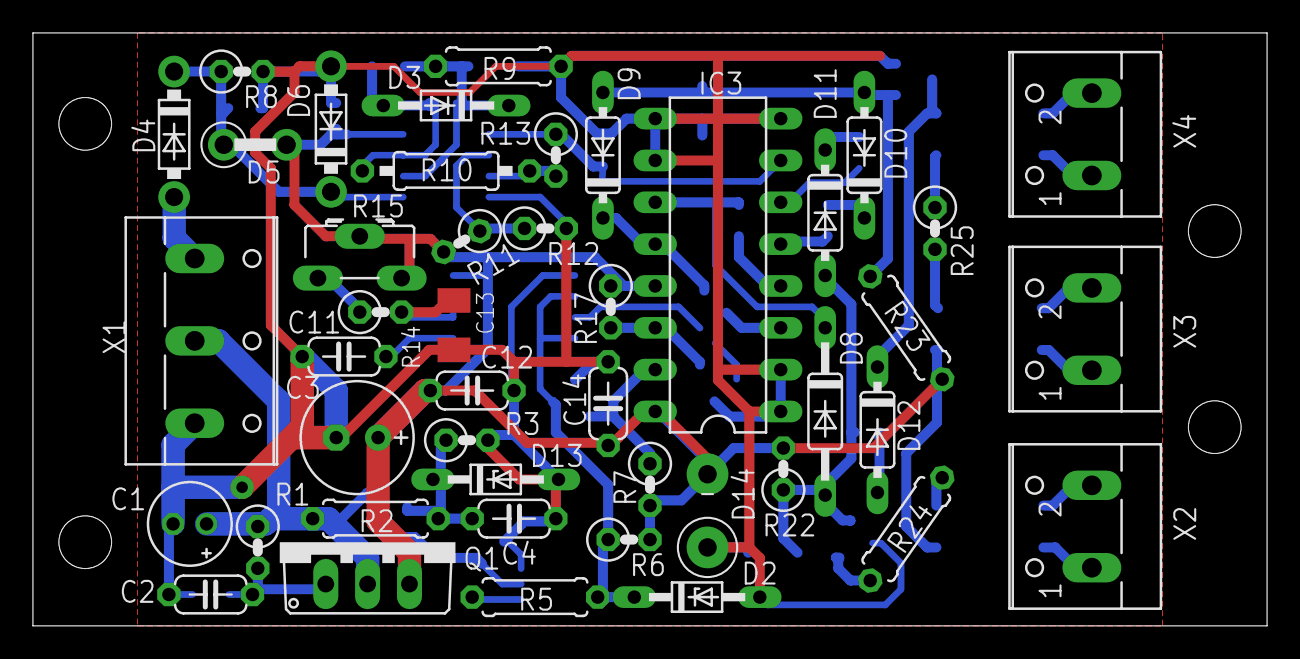
[picture p7: board InrushTimer.brd from above]

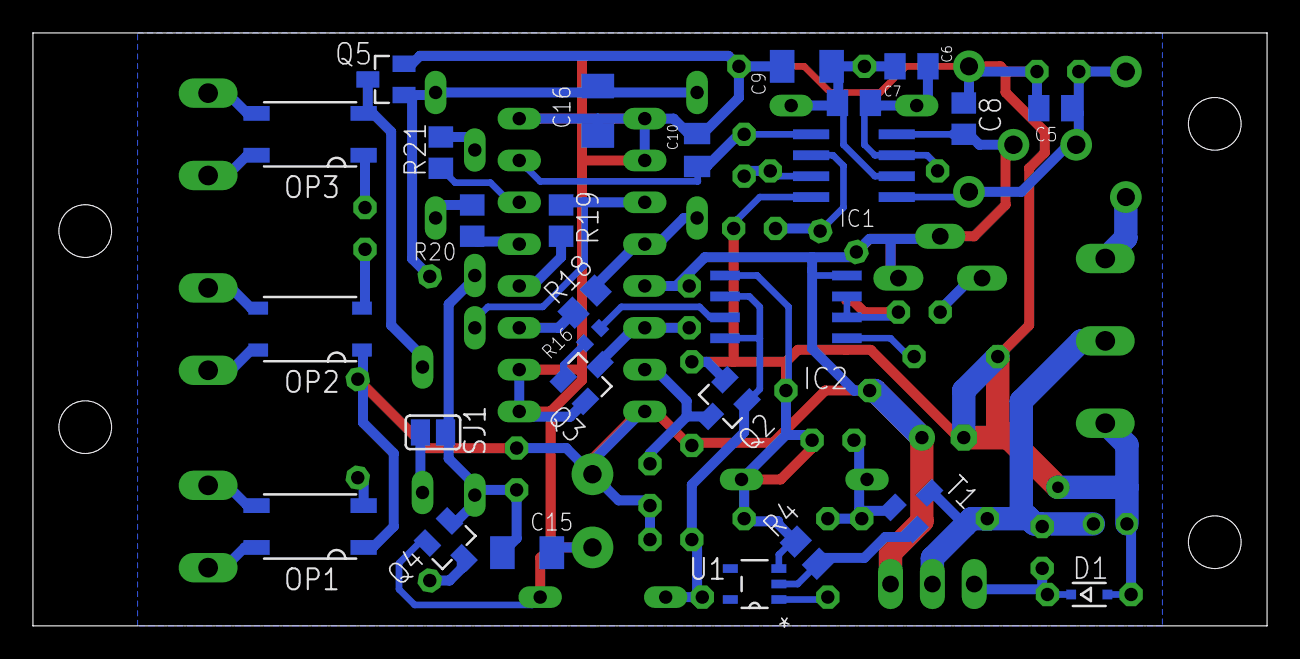
[picture p8: board InrushTimer.brd from below]

Board: 2 copper layers, 74.9 x 36.0 mm, 72 parts (27 on the bottom side), 44 nets.
