HMGrunthos/InrushTimer/SwitchingBoard.brd

## EAGLE design SwitchingBoard.brd (2022-05-04)

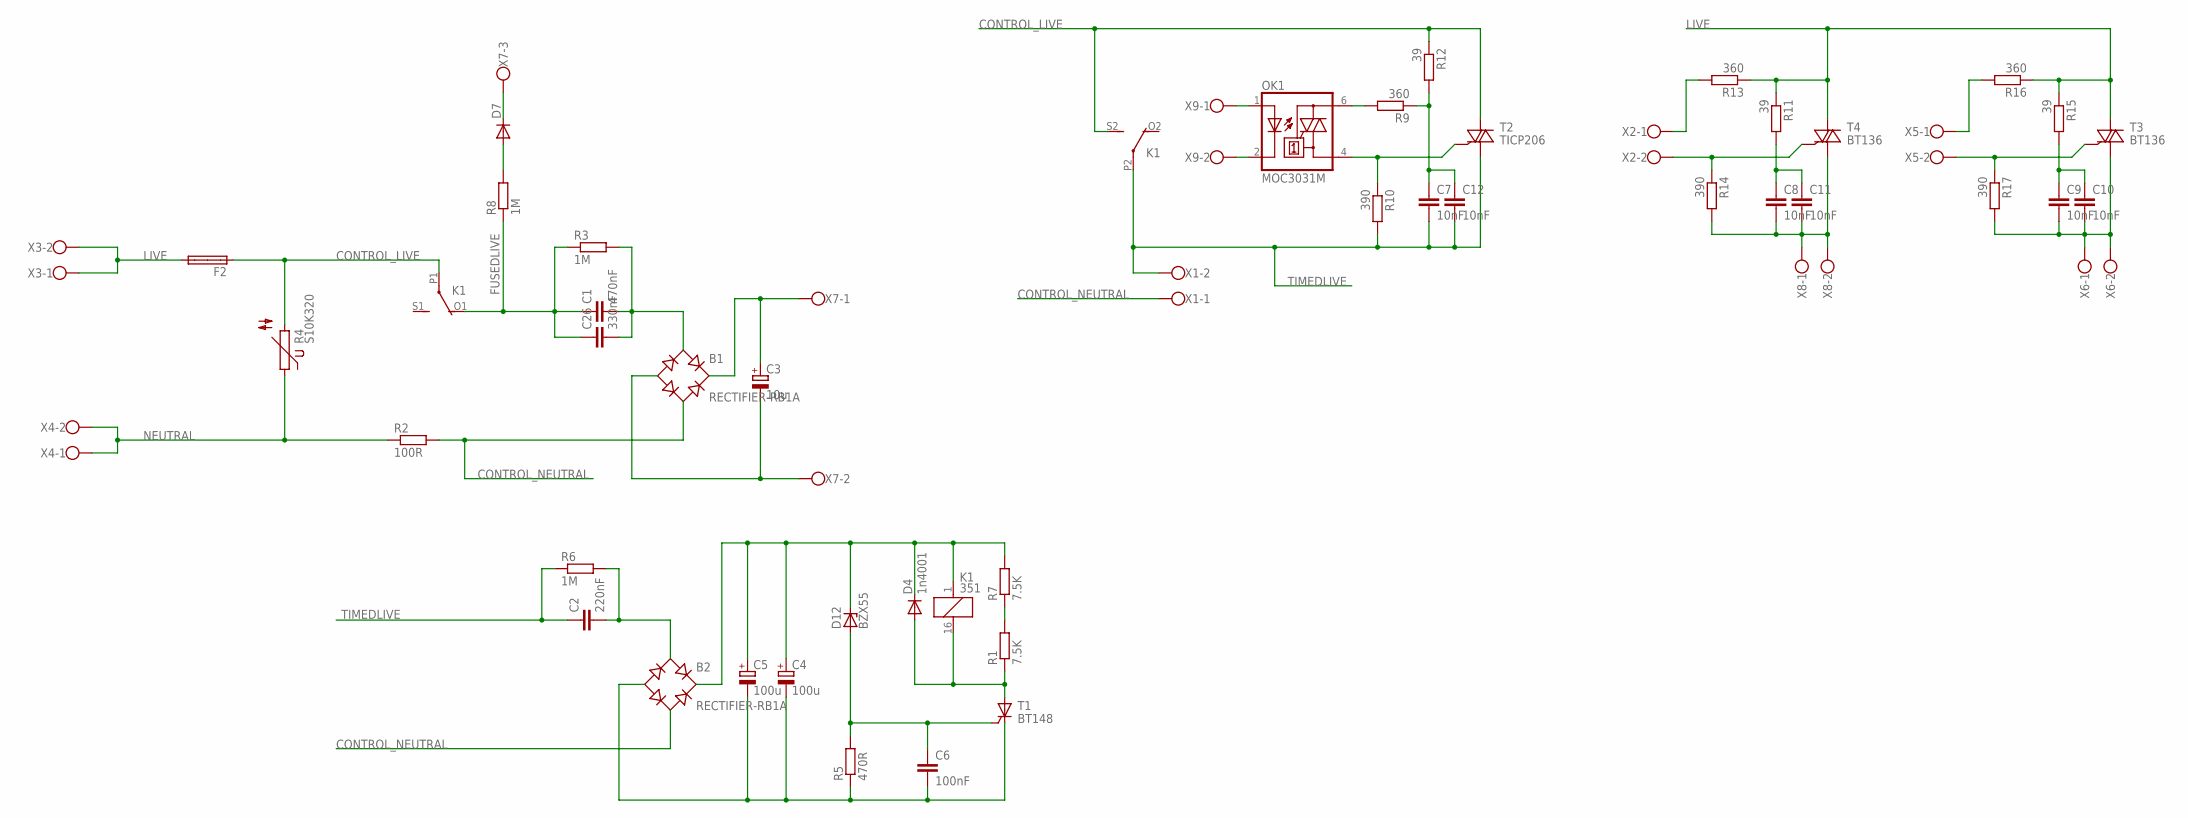
[picture p9: schematic SwitchingBoard.sch]

Parts:
B1, B2: RECTIFIER-RB1A; RB1A
C1: 470nF; C225-108X268
C2: 220nF; C225-062X268
C3: 10u; E2-5
C4, C5: 100u; E2,5-7
C6: 100nF; C050-024X044
C7, C8, C9: 10nF; C150-054X183
C10, C11, C12: 10nF; C102-043X133
C26: 330nF; C150-091X182
D4: 1n4001; DO41-10
D7: DIODE-DO41-10; DO41-10
D12: BZX55; DO35Z10
F2: SHKOG
K1: 351
OK1: MOC3031M; DIL06
R1, R7: 7.5K; 0207/7
R2: 100R; 0617/22
R3, R6, R8: 1M; 0617/22
R4: S10K320
R5: 470R; 0207/7
R9, R13, R16: 360; 0207/7
R10, R14, R17: 390; 0207/7
R11, R12, R15: 39; 0207/7
T1: BT148; SOT82S
T2: TICP206; TO92-6
T3, T4: BT136; TO220AB
X1, X2, X3, X4, X5, X6, X8, X9: W237-102
X7: W237-103

Connections:
CONTROL_LIVE: F2.1A, K1.P1, K1.S2 (S), R4.2, R12.1, T2.A2
CONTROL_NEUTRAL: B1.AC2, B2.AC2, R2.2, X1.1
FUSEDLIVE: C1.1, C26.1, K1.O1 (O), R3.1, R8.1
LIVE: F2.2A, R11.1, R13.1, R15.1, R16.1, T3.2 (A2), T4.2 (A2), X3.1, X3.2
unnamed: D7.A, R8.2
unnamed: B2.AC1, C2.2, R6.2
unnamed: R1.2, R7.1
unnamed: B1.AC1, C1.2, C26.2, R3.2
unnamed: D7.C, X7.3
unnamed: D4.A, K1.16 (2), R1.1, T1.A
unnamed: C6.1, D12.A, R5.2, T1.G
unnamed: C8.2, C11.2, R14.2, T4.1 (A1), X8.1, X8.2
unnamed: OK1.6 (A2), R9.2
unnamed: OK1.1 (A), X9.1
unnamed: C9.2, C10.2, R17.2, T3.1 (A1), X6.1, X6.2
unnamed: OK1.2 (C), X9.2
unnamed: OK1.4 (A1), R10.1, T2.G
unnamed: C7.1, C12.1, R9.1, R12.2
unnamed: R13.2, X2.1
unnamed: C8.1, C11.1, R11.2
unnamed: R14.1, T4.3 (G), X2.2
unnamed: C9.1, C10.1, R15.2
unnamed: R16.2, X5.1
unnamed: R17.1, T3.3 (G), X5.2
NEUTRAL: R2.1, R4.1, X4.1, X4.2
RECT: B1.+, C3.+, X7.1
RECTRELAY: B2.+, C4.+, C5.+, D4.C, D12.C, K1.1, R7.2
TIMEDLIVE: C2.1, C7.2, C12.2, K1.P2, R6.1, R10.2, T2.A1, X1.2
ZERO: B1.-, C3.-, X7.2
ZERO1: B2.-, C4.-, C5.-, C6.2, R5.1, T1.C

Board: 2 copper layers, 51 parts (0 on the bottom side), 30 nets, no tracks yet.
