HMGrunthos/InrushTimer/(commit log)

2018-07-06 Adding all inrush timer design files and libraries
2018-07-11 Added peak detector opamps
    [InrushTimer.brd, InrushTimer.sch]
2018-07-13 Still playing with 555 design, peak detector clock seems OK
    [InrushTimer.brd, InrushTimer.sch]
2018-08-28 Updating prior to PCB layout
    [InrushTimer.brd, InrushTimer.sch]
2018-08-28 Added 3.6V zenner
2022-04-25 Tweaked design and updated component footprints
    [InrushTimer.brd, InrushTimer.sch]
2022-04-28 Adding relay delay module and updates to inrush timer.
    [InrushTimer.brd, InrushTimer.sch]
2022-04-28 Updating with inrush model and chenges to cap values to support additional triac channel
    [InrushTimer.brd, InrushTimer.sch]
2022-04-30 Committing first cut of the board design. Two control signals unrouted.
    [InrushTimer.brd, InrushTimer.sch]
2022-05-01 Updated some component values and squished the timers further to the right.
    [InrushTimer.brd, InrushTimer.sch]
2022-05-01 Initial version of routed PCB. All traces routed and passes cursory DRC.
    [InrushTimer.brd, InrushTimer.sch]
2022-05-01 Tweaked layout to meet more exacting design rules.
    [InrushTimer.brd]
2022-05-01 Fixed missing track. Tweaked track widths.
    [InrushTimer.brd]
2022-05-01 Fixed an incorred footprint.
    [InrushTimer.brd, InrushTimer.sch]
2022-05-02 Tidied up some traces and improved trace seraration.
    [InrushTimer.brd, InrushTimer.sch]
2022-05-03 Trace adjustments.
    [InrushTimer.brd]
2022-05-04 Adding switching board design.
    [SwitchingBoard.brd, SwitchingBoard.sch]
2022-05-04 Updated schematics and parts for the switching board.
    [SwitchingBoard.brd, SwitchingBoard.sch]
2022-05-05 Checking in first version of the switching board layed out in KiCad
    [SwitchingBoard.kicad_pcb, SwitchingBoard.kicad_sch]
2022-05-05 KiCad switching board schematic passes initial ERC.
    [SwitchingBoard.kicad_sch]
2022-05-05 Assigned footprints
    [SwitchingBoard.kicad_sch]
2022-05-05 Initial grouping of components on PCB
    [SwitchingBoard.kicad_pcb, SwitchingBoard.kicad_sch]
2022-05-07 Tweaked layout based on autorouter run.
    [InrushTimer.brd, InrushTimer.sch]
2022-05-07 Updated schematics and board to address error in aux output assignment.
    [InrushTimer.brd, InrushTimer.sch]
2022-05-12 Committing changes to circuit to remove a time and put the optoisolators into series.
    [InrushTimer.brd, InrushTimer.sch]
2022-05-12 Simplified resistive divider setup.
2022-05-13 Updated model and board with circuit and component values.
    [InrushTimer.brd, InrushTimer.sch]
2022-05-13 Changed gate resistors and checked component values.
    [InrushTimer.brd, InrushTimer.sch]
2022-05-13 Added inductor model and tweaked schematic.
    [InrushTimer.brd, InrushTimer.sch]
2022-05-14 Fixed inverted comparator and actually calculated hysteresis resistors!
2022-05-14 Updated values and topology on schematic.
    [InrushTimer.brd, InrushTimer.sch]
2022-05-14 Corrected component values (units)
    [InrushTimer.brd, InrushTimer.sch]
2022-05-14 Tidied up model schematic.
2022-05-14 Updated optotriac symbol
    [InrushTimer.brd, InrushTimer.sch]
2022-05-14 Fixed missing libraries by moving parts into local lib. Renumbered components.
    [InrushTimer.brd, InrushTimer.sch]
2022-05-14 Updated component packages
    [InrushTimer.brd, InrushTimer.sch]
2022-05-14 Updated zener model and added annotation on schematic.
    [InrushTimer.brd, InrushTimer.sch]
2022-05-15 Added measurements for peak clock rise and fall time. Tidied up library imports. Sorted out gate capacitance on output of comparator.
2022-05-15 Removed ||'ll resistance for looking at peak voltage. Removed unused models.
2022-05-15 Re-layed out peak detector, supply and reset generator.
    [InrushTimer.brd, InrushTimer.sch]
2022-05-15 Layout changes.
    [InrushTimer.brd]
2022-05-16 Removed optocoupler from this board and updated the fuseholder footprint.
    [SwitchingBoard.kicad_pcb, SwitchingBoard.kicad_sch]
2022-05-17 ayed out the timer - starting on the D types. Fixed incorrect gate capacitance.
    [InrushTimer.brd, InrushTimer.sch]
2022-05-17 Added custom fuse footprint and updated PCB.
    [SwitchingBoard.kicad_pcb, SwitchingBoard.kicad_sch]
2022-05-17 Refitted the timer and pulse generator.
    [InrushTimer.brd, InrushTimer.sch]
2022-05-17 Everything on the board - not routed.
    [InrushTimer.brd]
2022-05-17 Added a couple more power routes.
    [InrushTimer.brd]
2022-05-18 First complete routing fit. Passes design rules.
    [InrushTimer.brd, InrushTimer.sch]
2022-05-18 Slight track style tweaks.
    [InrushTimer.brd, InrushTimer.sch]
2022-05-20 Pushed some tracks to the bottom side
    [InrushTimer.brd, InrushTimer.sch]
2022-05-20 Adjusted resistor value
2022-05-20 Shifted component to the bottom layer and adjusted some track placements.
    [InrushTimer.brd, InrushTimer.sch]
2022-05-20 Track and component positions.
    [InrushTimer.brd]
2022-05-20 Tidied up component and track placement.
    [InrushTimer.brd, InrushTimer.sch]
2022-05-20 Rev two layout - minor change to track angle
    [InrushTimer.brd]
2022-05-23 Added photo of PCB processing notes.
2022-05-25 Changed pass element to TIP41C and moved some components around to make more space.
    [InrushTimer.brd, InrushTimer.sch]
2022-05-25 Rerouted power supply section and made some space around the pot.
    [InrushTimer.brd, InrushTimer.sch]
2022-05-25 Fixed some component orientations.
    [InrushTimer.brd, InrushTimer.sch]
2022-05-26 Tweaked ground and component positions - still to do; adjust pad sizes.
    [InrushTimer.brd]
2022-05-27 Increased TH pad sizes and adjusted component positions to pass DRC.
    [InrushTimer.brd, InrushTimer.sch]
2022-05-29 Tweaked track position.
    [InrushTimer.brd]
2022-06-01 Playing with layout and routing in KiCad
    [SwitchingBoard.kicad_pcb, SwitchingBoard.kicad_sch]
2022-06-03 Shuffled component placement to avoid via.
    [SwitchingBoard.kicad_pcb]
2022-06-03 Fixed TRIAC symbol and tweaked layout further.
    [SwitchingBoard.kicad_pcb, SwitchingBoard.kicad_sch]
2022-08-25 Added duplicated resistors to hit worst case voltage ratings.
    [SwitchingBoard.kicad_sch]
2022-10-17 Fixed up silkscreen and added job file from JLCPCB
    [InrushTimer.brd, InrushTimer.sch]
2022-10-17 More silkscreen fixes.
    [InrushTimer.brd]
2022-10-18 Checked in gerber files for inrush timer production.
    [InrushTimer.GBL, InrushTimer.GBO, InrushTimer.GBP, InrushTimer.GBS, InrushTimer.GKO, InrushTimer.GTL, InrushTimer.GTO, InrushTimer.GTP]
2022-12-14 Fixed schematic connections.
    [SwitchingBoard.kicad_sch]
2024-02-17 Added missing diode model
2024-02-17 Attempt to fix a reported issue with the diode syntax in pspice.
